petruspierre/jedi/ALPHA IFPB-JP_FotoRobo.jpg

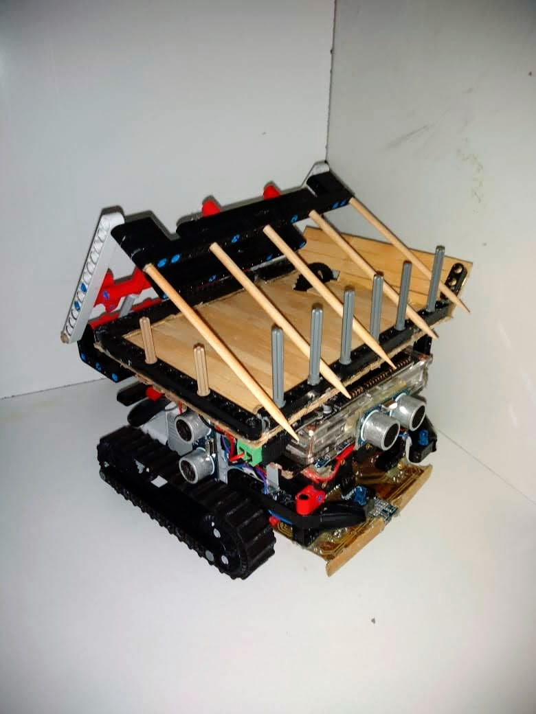
ALPHA IFPB-JP_FotoRobo.jpg
