petruspierre/jedi/README.md

# Jedi

You can see the informations more detailed [clicking here](https://github.com/petruspierre/jedi/blob/master/diario.pdf) but it is in portuguese.

## Introduction

Jedi was the name that me and my team choose for this robot that have these two blue leds on the front that looks like a lightsaber for Brazilian Robotics Olympics.<br>
Jedi

First of all we need to know what is the Brazilian Robotics Olympics [(OBR)](http://www.obr.org.br).
Well, picking the description of the competition in the site we have:

> *The Brazilian Robotics Olympics (OBR) is one of the Brazilian Scientific Olympics that uses the theme of robotics.*

Field

There is two modalities in this Olympics, but we will focus in the Practical one.

In the Practical modality we have an challenge very similar to Robocup Line Rescue. So we have an field with some black and green tape and the robot should pass through the path and at the final rescue some balls that represents victims of a disaster.

## Hardware

We started by the *batteries* that we would use in the robot. So we choose 4 notebook cells of Lithium battery for it. And for the charge were TP4056 controllers.

Then we did the circuit board that would have the 7 TCRT5000 we used to follow the black line and read the green squares.<br>
We did some prototypes. The first one that we made using Fritzing is below:

first_circuit

> *Note that was the first PCB board we have ever made*

and the **definitive one** using ARES Proteus 7:

last_circuit
board

And the final circuit

circuit

## Line follower logic

logic

You can find the implementation [here](https://github.com/petruspierre/jedi/blob/master/nacional/nacional.ino), but it is basically the "ifs" calling the functions that handle with each of these situations.

## Rescue logic

For the rescue is there is almost none sensor reading, just motor actions being executed, so we did some schemes like that:

rescue

You can see the program clicking [here](https://github.com/petruspierre/jedi/blob/master/nacional/resgate.ino) but this archive is incomplete.

# IFPB Alpha
- Petrus Pierre
- Yuri Monteiro
- João Rafael
- Ádisson Matheus
