petruspierre/jedi/sensorobr.PDF

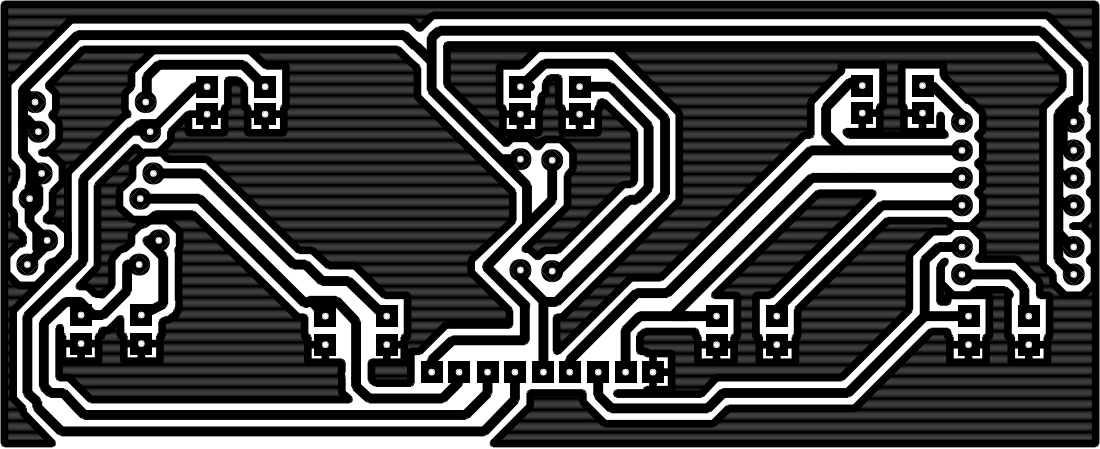
[picture p14: page 1]
